citizenanalog/klofi/README.md

# ᚴᛚᚢᚠᛁ keyboard

The ᚴᛚᚢᚠᛁ (Corne v4 variant) keyboard is a split keyboard with 3x5 or 3x6 column staggered keys
and 3 thumb keys.



## EMI FIX (by colinski8189)
- TL;DR: Now a 4 layer board with more components, to mitigate EMI issues (USB and TRS had major issues specifically called out, these have been addressed).

## USBC interconnect
- Eliminates the TRS/TRRS connection in favor of USBC.
- b2b_usbc

## Update
- MX version is currently being tested, 3x5_3_ex2 and 3x6_3_ex2. Physically the same dimensions as corne v4 except for new USBC conn.
- choc versions (3x5 and 3x6 layouts) are routed but not yet produced. Note there are separate PCB files for 3x5 and 3x6.
