citizenanalog/klofi/plates/3x5/pcb/plate-top-cherrymx-ex-3x5.step

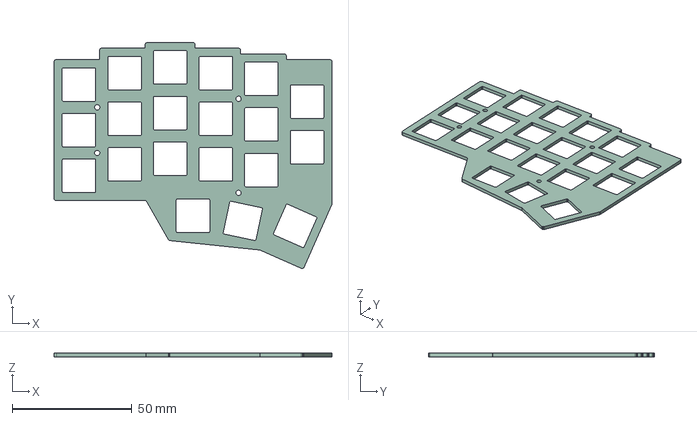
[picture p1: CAD file, 2026-01-19]
plates/3x5/pcb/plate-top-cherrymx-ex-3x5.step
116.1 x 94.4 x 1.51 mm
