citizenanalog/klofi/pcbs/common/left.kicad_sch

## KiCad design pcbs/common/left.kicad_sch (2025-12-11)

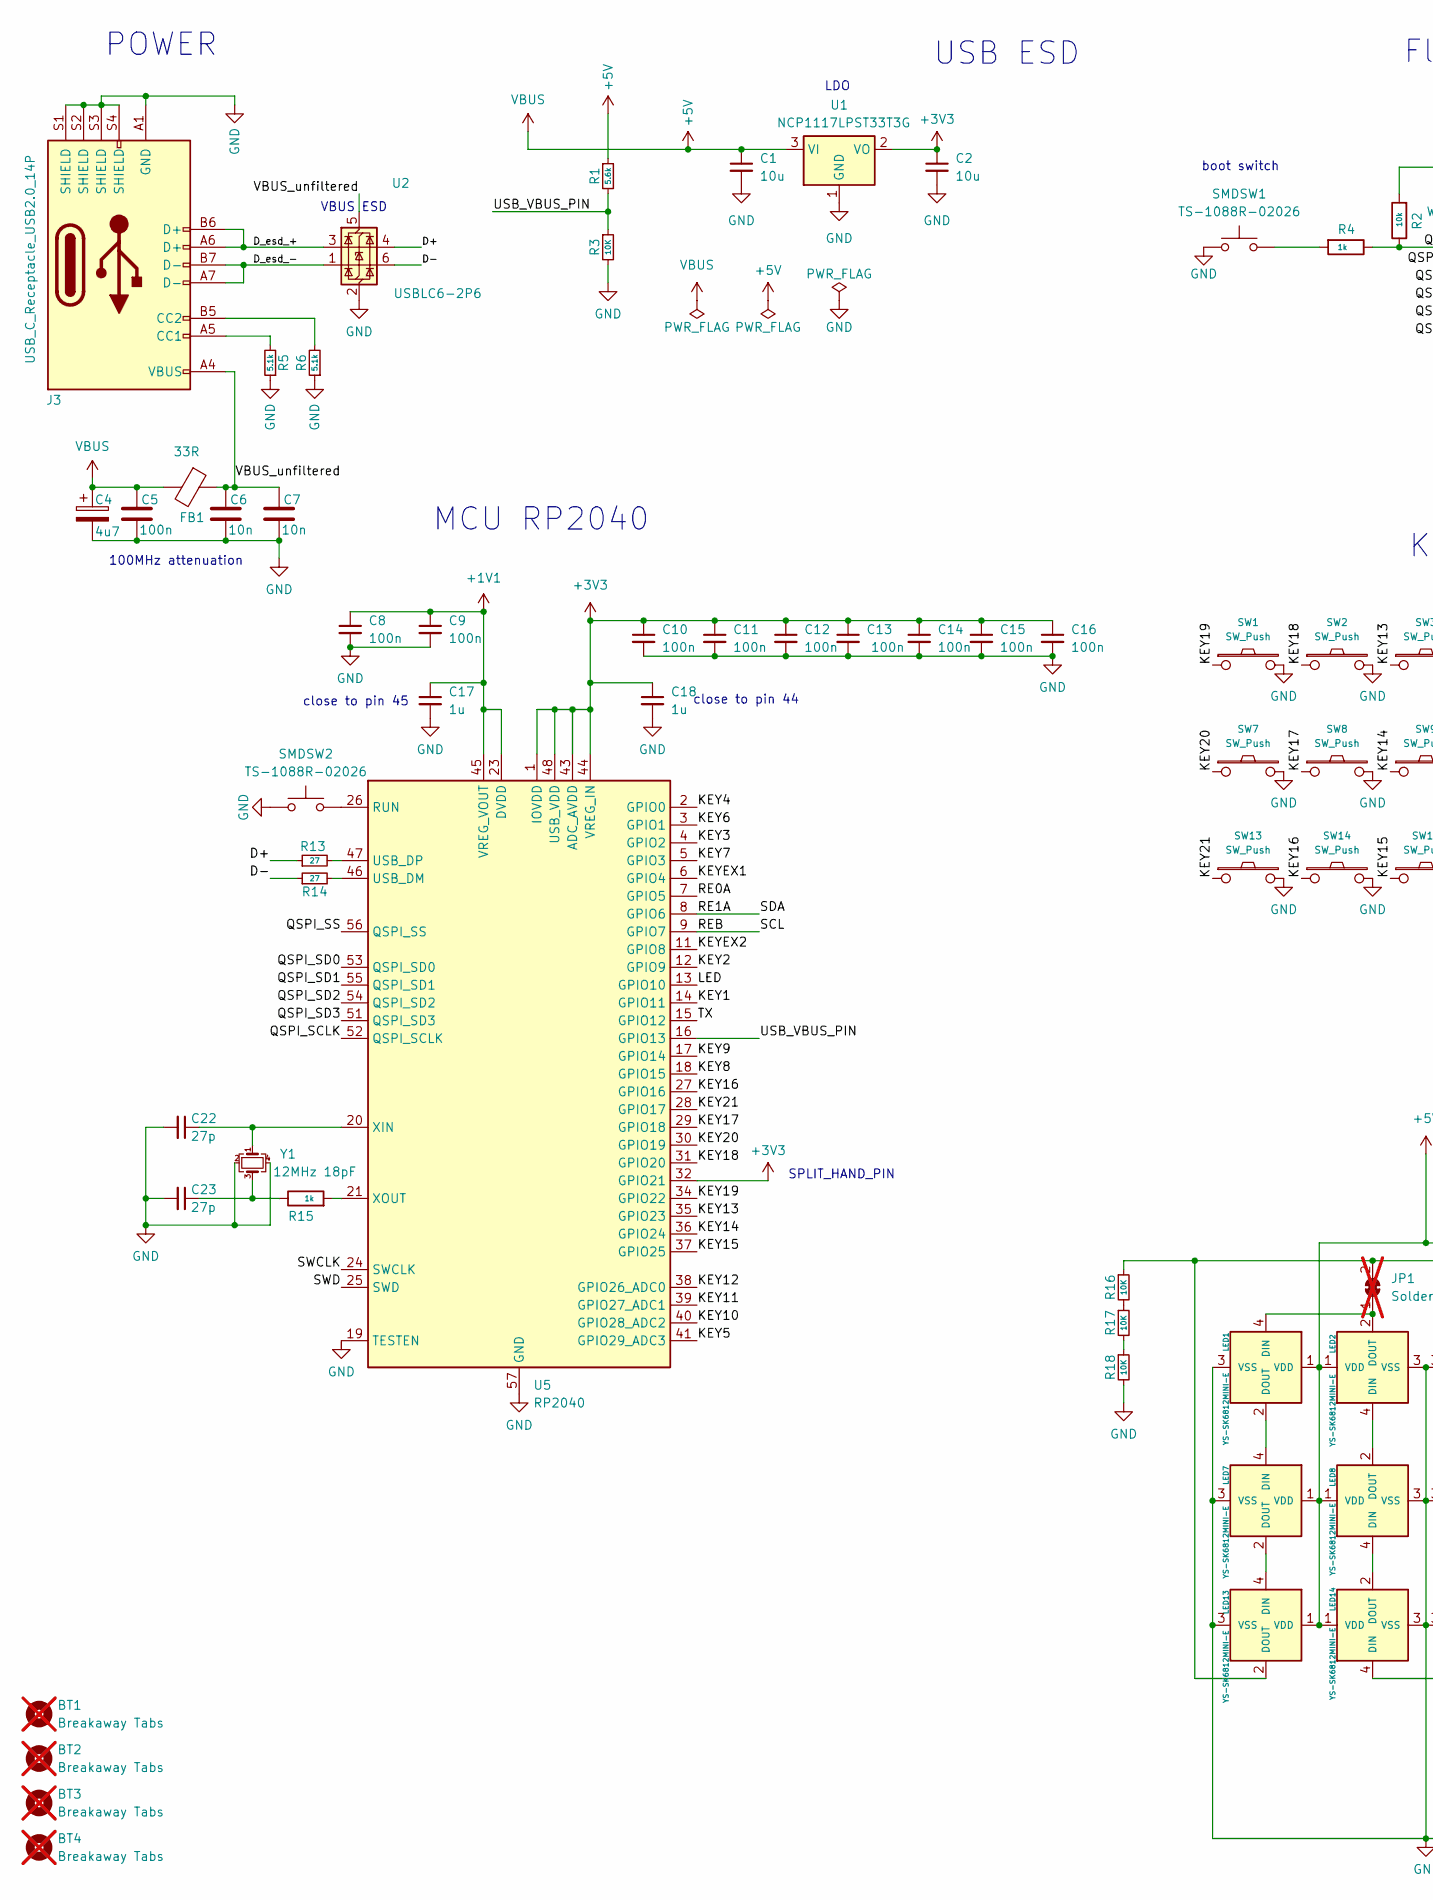
[picture p2: schematic left.kicad_sch, part in row 1, column 1]

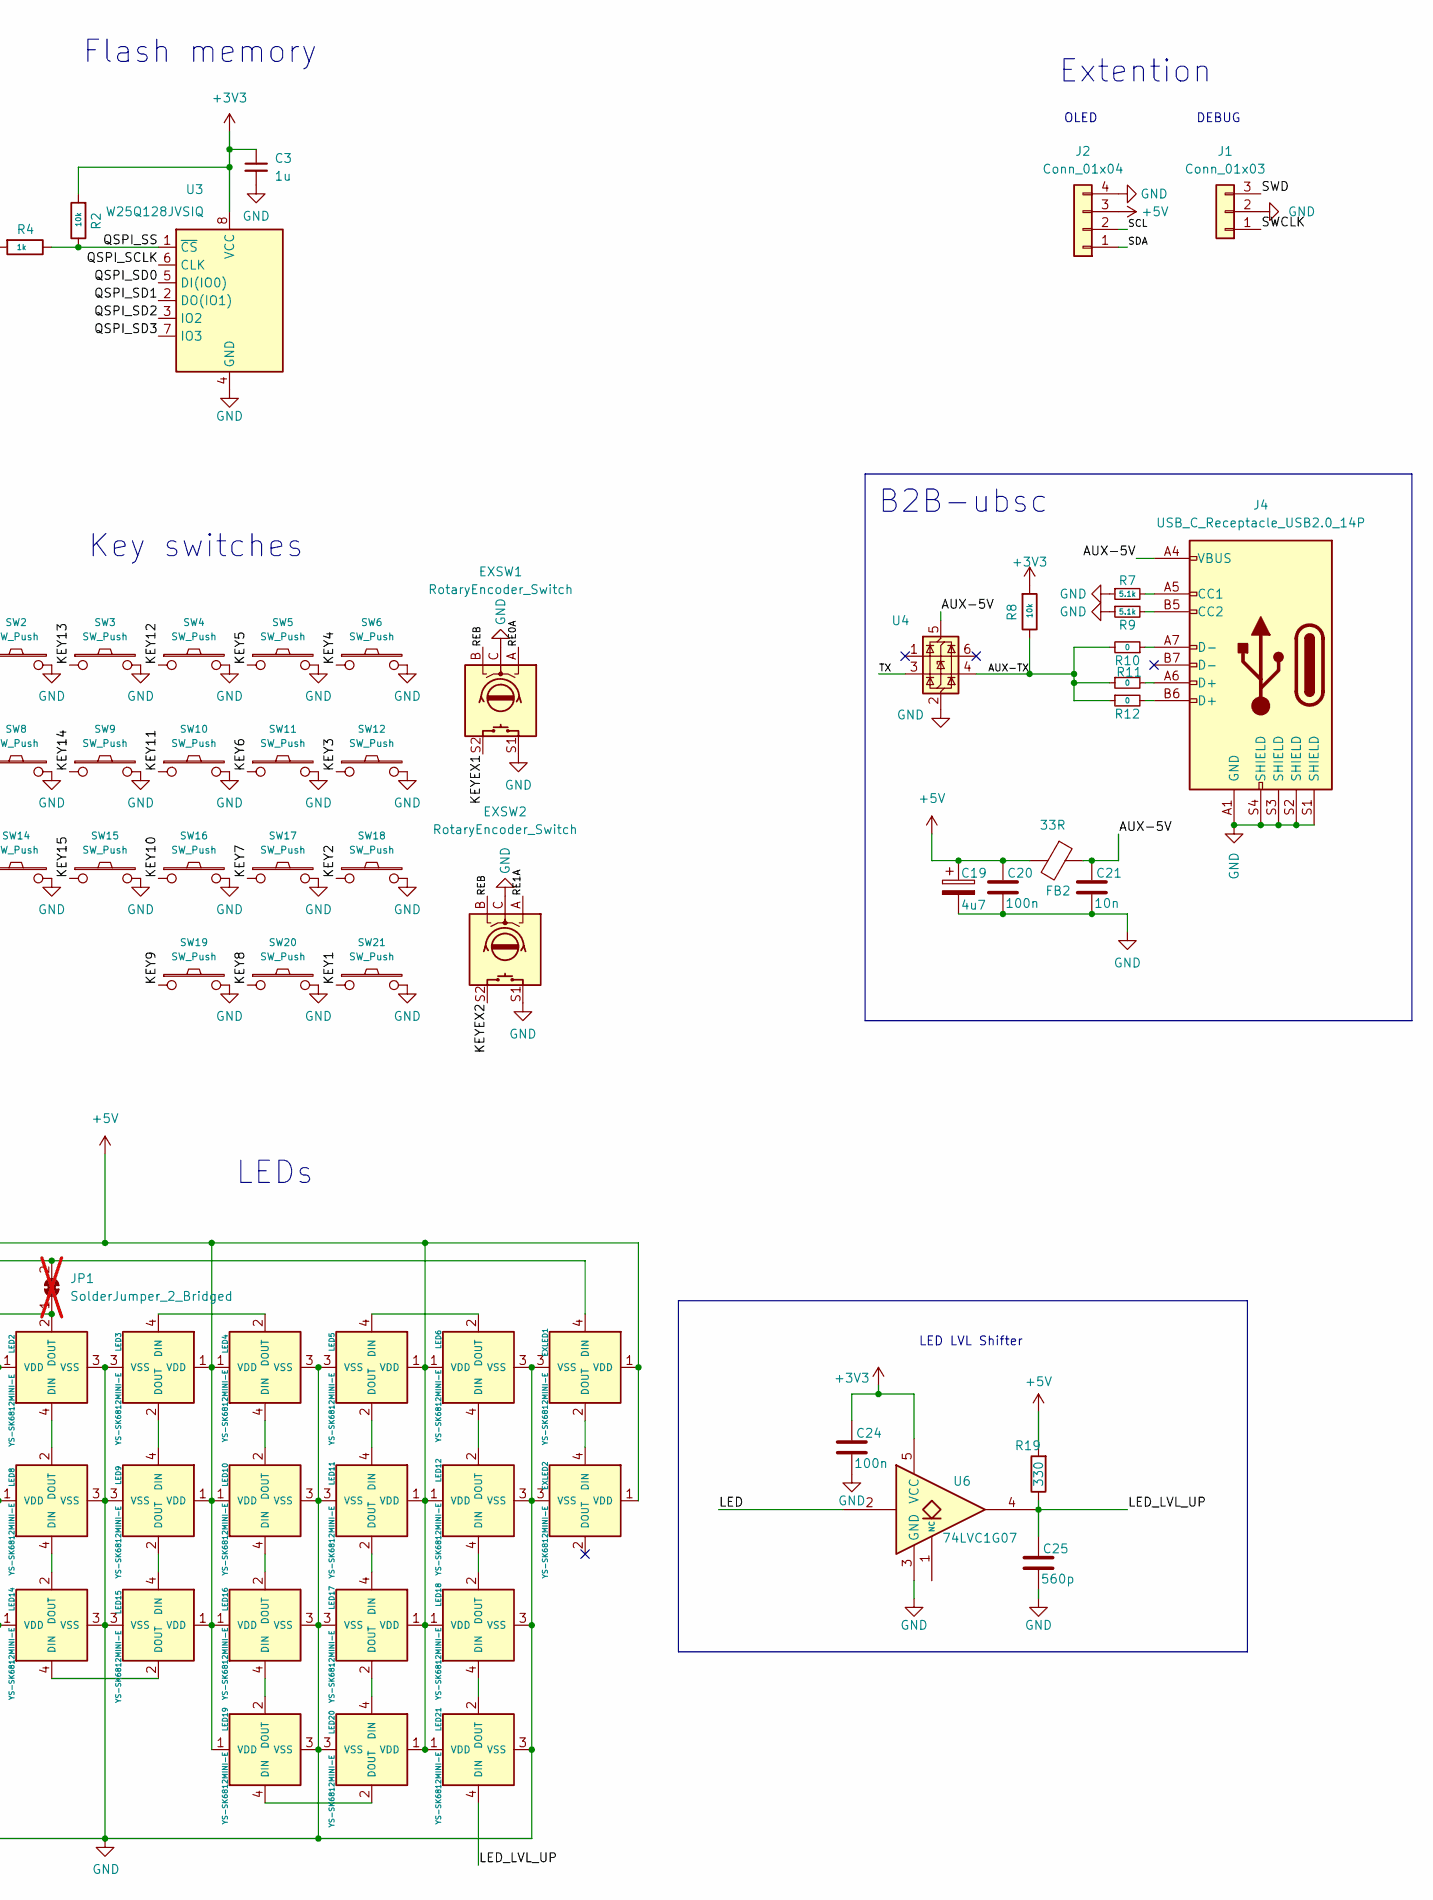
[picture p3: schematic left.kicad_sch, part in row 1, column 2]

Parts:
BT1, BT2, BT3, BT4: Breakaway Tabs; Breakaway_Tabs; not fitted
C1, C2: 10u; C_0402_1005Metric; JLCPCB Part # C15525
C3, C17, C18: 1u; C_0402_1005Metric; JLCPCB Part # C14445
C4, C19: 4u7; C_1210_3225Metric; Manufacturer Part # TCJB475M035R0200; LCSC Part # C2158392
C5, C20, C24: 100n; C_0402_1005Metric; Manufacturer Part # CL05B104KP5NNNC; LCSC Part # C133086
C6, C7, C21: 10n; C_0402_1005Metric; Manufacturer Part # GRM155R71E103KA01D; LCSC Part # C77013
C8, C9, C10, C11, C12, C13, C14, C15, C16: 100n; C_0402_1005Metric; JLCPCB Part # C133086
C22, C23: 27p; C_0402_1005Metric; JLCPCB Part # C86287
C25: 560p; C_0402_1005Metric; Manufacturer Part # GRM1555C1H561JA01D; LCSC Part # C76975
EXLED1, EXLED2: YS-SK6812MINI-E; JLCPCB Part # C5149201
EXSW1, EXSW2: RotaryEncoder_Switch; keyswitch_cherrymx_hotswap_1u_rotary_encoder_ec12; JLCPCB Part # DNP
FB1, FB2: 33R; L_1206_3216Metric; Manufacturer Part # BLM31PG330SN1L; LCSC Part # C6750934
J1: Conn_01x03; PinHeader_1x03_P2.54mm_Vertical; JLCPCB Part # DNP
J2: Conn_01x04; OLED; JLCPCB Part # DNP
J3, J4: USB_C_Receptacle_USB2.0_14P; 2073-USB4105-GF-ACT-ND; Manufacturer Part # USB4105-GF-A; LCSC Part # C3020560
JP1: SolderJumper_2_Bridged; SolderJumper-2_P1.3mm_Open_RoundedPad1.0x1.5mm; JLCPCB Part # DNP; not fitted
LED1, LED2, LED3, LED4, LED5, LED6, LED7, LED8, LED9, LED10, LED11, LED12, LED13, LED14, LED15, LED16, LED17, LED18, LED19, LED20, LED21: YS-SK6812MINI-E; JLCPCB Part # C5149201
R1: 5.6k; R_0402_1005Metric; JLCPCB Part # C25908
R2, R8: 10k; R_0402_1005Metric; JLCPCB Part # C60489
R3, R16, R17, R18: 10K; R_0402_1005Metric; JLCPCB Part # C60489
R4, R15: 1k; R_0402_1005Metric; JLCPCB Part # C71623
R5, R6, R7, R9: 5.1k; R_0402_1005Metric; JLCPCB Part # C105872
R10, R11, R12: 0; R_0402_1005Metric; JLCPCB Part # C25537
R13, R14: 27; R_0402_1005Metric; JLCPCB Part # C138021
R19: 330; R_0402_1005Metric; Manufacturer Part # RC0402FR-07330RL; LCSC Part # C105875
SMDSW1, SMDSW2: TS-1088R-02026; JLCPCB Part # C455280
SW1, SW2, SW3, SW4, SW5, SW6, SW7, SW8, SW9, SW10, SW11, SW12, SW13, SW14, SW15, SW16, SW17, SW18, SW19, SW20, SW21: SW_Push; keyswitch_cherrymx_hotswap_1u; JLCPCB Part # DNP
U1: NCP1117LPST33T3G; SOT-223-3_TabPin2; JLCPCB Part # C146799
U2, U4: USBLC6-2P6; SOT-666; Manufacturer Part # USBLC6-2P6; LCSC Part # C15999
U3: W25Q128JVSIQ; SOIC-8_5.23x5.23mm_P1.27mm; JLCPCB Part # C113767
U5: RP2040; QFN-56-1EP_7x7mm_P0.4mm_EP3.2x3.2mm; JLCPCB Part # C2040
U6: 74LVC1G07; SOT-353_SC-70-5; Manufacturer Part # SN74LVC1G07DCKR; LCSC Part # C7830
Y1: 12MHz 18pF; Crystal_SMD_3225-4Pin_3.2x2.5mm; MFR.Part # Q22FA23V0041800; JLCPCB Part # C91749

Connections:
+1V1: C8.1, C9.1, C17.1, U5.23 (DVDD), U5.45 (VREG_VOUT), U5.50 (DVDD)
+3V3: C2.1, C3.1, C10.1, C11.1, C12.1, C13.1, C14.1, C15.1, C16.1, C18.1, C24.1, R2.2, R8.2, U1.2 (VO), U3.8 (VCC), U5.1 (IOVDD), U5.10 (IOVDD), U5.22 (IOVDD), U5.32 (GPIO21), U5.33 (IOVDD), U5.42 (IOVDD), U5.43 (ADC_AVDD), U5.44 (VREG_IN), U5.48 (USB_VDD), U5.49 (IOVDD), U6.5 (VCC)
+5V: C1.1, C4.1, C5.1, C19.1, C20.1, EXLED1.1 (VDD), EXLED2.1 (VDD), FB1.2, FB2.2, J2.3, LED1.1 (VDD), LED2.1 (VDD), LED3.1 (VDD), LED4.1 (VDD), LED5.1 (VDD), LED6.1 (VDD), LED7.1 (VDD), LED8.1 (VDD), LED9.1 (VDD), LED10.1 (VDD), LED11.1 (VDD), LED12.1 (VDD), LED13.1 (VDD), LED14.1 (VDD), LED15.1 (VDD), LED16.1 (VDD), LED17.1 (VDD), LED18.1 (VDD), LED19.1 (VDD), LED20.1 (VDD), LED21.1 (VDD), R1.1, R19.2, U1.3 (VI)
AUX-5V: C21.1, FB2.1, J4.A4 (VBUS), J4.B4 (VBUS), U4.5 (VBUS)
AUX-TX: R8.1, R10.2, R11.1, R12.1, U4.4 (I/O2)
D+: R13.1, U2.4 (I/O1)
D-: R14.1, U2.6 (I/O2)
D_esd_+: J3.A6 (D+), J3.B6 (D+), U2.3 (I/O1)
D_esd_-: J3.A7 (D-), J3.B7 (D-), U2.1 (I/O2)
GND: C1.2, C2.2, C3.2, C4.2, C5.2, C6.2, C7.2, C8.2, C9.2, C10.2, C11.2, C12.2, C13.2, C14.2, C15.2, C16.2, C17.2, C18.2, C19.2, C20.2, C21.2, C22.2, C23.2, C24.2, C25.2, EXLED1.3 (VSS), EXLED2.3 (VSS), EXSW1.C, EXSW1.S1, EXSW2.C, EXSW2.S1, J1.2, J2.4, J3.A1 (GND), J3.B1 (GND), J3.S1 (SHIELD), J3.S2 (SHIELD), J3.S3 (SHIELD), J3.S4 (SHIELD), J4.A1 (GND), J4.B1 (GND), J4.S1 (SHIELD), J4.S2 (SHIELD), J4.S3 (SHIELD), J4.S4 (SHIELD), LED1.3 (VSS), LED2.3 (VSS), LED3.3 (VSS), LED4.3 (VSS), LED5.3 (VSS), LED6.3 (VSS), LED7.3 (VSS), LED8.3 (VSS), LED9.3 (VSS), LED10.3 (VSS), LED11.3 (VSS), LED12.3 (VSS), LED13.3 (VSS), LED14.3 (VSS), LED15.3 (VSS), LED16.3 (VSS), LED17.3 (VSS), LED18.3 (VSS), LED19.3 (VSS), LED20.3 (VSS), LED21.3 (VSS), R3.2, R5.1, R6.1, R7.1, R9.1, R18.2, SMDSW1.1, SMDSW2.1, SW1.2, SW2.2, SW3.2, SW4.2, SW5.2, SW6.2, SW7.2, SW8.2, SW9.2, SW10.2, SW11.2, SW12.2, SW13.2, SW14.2, SW15.2, SW16.2, SW17.2, SW18.2, SW19.2, SW20.2, SW21.2, U1.1 (GND), U2.2 (GND), U3.4 (GND), U4.2 (GND), U5.19 (TESTEN), U5.57 (GND), U6.3 (GND), Y1.2, Y1.4
KEY1: SW21.1, U5.14 (GPIO11)
KEY2: SW18.1, U5.12 (GPIO9)
KEY3: SW12.1, U5.4 (GPIO2)
KEY4: SW6.1, U5.2 (GPIO0)
KEY5: SW5.1, U5.41 (GPIO29_ADC3)
KEY6: SW11.1, U5.3 (GPIO1)
KEY7: SW17.1, U5.5 (GPIO3)
KEY8: SW20.1, U5.18 (GPIO15)
KEY9: SW19.1, U5.17 (GPIO14)
KEY10: SW16.1, U5.40 (GPIO28_ADC2)
KEY11: SW10.1, U5.39 (GPIO27_ADC1)
KEY12: SW4.1, U5.38 (GPIO26_ADC0)
KEY13: SW3.1, U5.35 (GPIO23)
KEY14: SW9.1, U5.36 (GPIO24)
KEY15: SW15.1, U5.37 (GPIO25)
KEY16: SW14.1, U5.27 (GPIO16)
KEY17: SW8.1, U5.29 (GPIO18)
KEY18: SW2.1, U5.31 (GPIO20)
KEY19: SW1.1, U5.34 (GPIO22)
KEY20: SW7.1, U5.30 (GPIO19)
KEY21: SW13.1, U5.28 (GPIO17)
KEYEX1: EXSW1.S2, U5.6 (GPIO4)
KEYEX2: EXSW2.S2, U5.11 (GPIO8)
LED: U5.13 (GPIO10), U6.2
LED_LVL_UP: C25.1, LED21.4 (DIN), R19.1, U6.4
unnamed: C22.1, U5.20 (XIN), Y1.1
unnamed: C23.1, R15.1, Y1.3
unnamed: EXLED1.2 (DOUT), EXLED2.4 (DIN)
unnamed: EXLED1.4 (DIN), JP1.2 (B), LED13.2 (DOUT), R16.1
unnamed: J3.A5 (CC1), R5.2
unnamed: J3.B5 (CC2), R6.2
unnamed: J4.A5 (CC1), R7.2
unnamed: J4.A6 (D+), R11.2
unnamed: J4.A7 (D-), R10.1
unnamed: J4.B5 (CC2), R9.2
unnamed: J4.B6 (D+), R12.2
unnamed: JP1.1 (A), LED1.4 (DIN), LED2.2 (DOUT)
unnamed: LED1.2 (DOUT), LED7.4 (DIN)
unnamed: LED2.4 (DIN), LED8.2 (DOUT)
unnamed: LED3.2 (DOUT), LED9.4 (DIN)
unnamed: LED3.4 (DIN), LED4.2 (DOUT)
unnamed: LED5.4 (DIN), LED6.2 (DOUT)
unnamed: LED4.4 (DIN), LED10.2 (DOUT)
unnamed: LED10.4 (DIN), LED16.2 (DOUT)
unnamed: LED11.2 (DOUT), LED17.4 (DIN)
unnamed: LED5.2 (DOUT), LED11.4 (DIN)
unnamed: LED6.4 (DIN), LED12.2 (DOUT)
unnamed: LED12.4 (DIN), LED18.2 (DOUT)
unnamed: LED7.2 (DOUT), LED13.4 (DIN)
unnamed: LED8.4 (DIN), LED14.2 (DOUT)
unnamed: LED14.4 (DIN), LED15.2 (DOUT)
unnamed: LED9.2 (DOUT), LED15.4 (DIN)
unnamed: LED16.4 (DIN), LED19.2 (DOUT)
unnamed: LED17.2 (DOUT), LED20.4 (DIN)
unnamed: LED18.4 (DIN), LED21.2 (DOUT)
unnamed: LED19.4 (DIN), LED20.2 (DOUT)
unnamed: R4.2, SMDSW1.2
unnamed: R13.2, U5.47 (USB_DP)
unnamed: R14.2, U5.46 (USB_DM)
unnamed: R15.2, U5.21 (XOUT)
unnamed: R16.2, R17.1
unnamed: R17.2, R18.1
unnamed: SMDSW2.2, U5.26 (RUN)
QSPI_SCLK: U3.6 (CLK), U5.52 (QSPI_SCLK)
QSPI_SD0: U3.5 (DI(IO0)), U5.53 (QSPI_SD0)
QSPI_SD1: U3.2 (DO(IO1)), U5.55 (QSPI_SD1)
QSPI_SD2: U3.3 (IO2), U5.54 (QSPI_SD2)
QSPI_SD3: U3.7 (IO3), U5.51 (QSPI_SD3)
QSPI_SS: R2.1, R4.1, U3.1 (~CS), U5.56 (QSPI_SS)
RE0A: EXSW1.A, U5.7 (GPIO5)
RE1A: EXSW2.A, J2.1, U5.8 (GPIO6)
REB: EXSW1.B, EXSW2.B, J2.2, U5.9 (GPIO7)
SWCLK: J1.1, U5.24 (SWCLK)
SWD: J1.3, U5.25 (SWD)
TX: U4.3 (I/O2), U5.15 (GPIO12)
USB_VBUS_PIN: R1.2, R3.1, U5.16 (GPIO13)
VBUS_unfiltered: C6.1, C7.1, FB1.1, J3.A4 (VBUS), J3.B4 (VBUS), U2.5 (VBUS)

Notes on the sheet:
MCU RP2040
Key switches
OLED
100MHz attenuation
close to pin 45
DEBUG
LED LVL Shifter
USB ESD
LDO
Flash memory
POWER
LEDs
Extention
VBUS ESD
SPLIT_HAND_PIN
boot switch
B2B-ubsc
close to pin 44
