citizenanalog/klofi/pcbs/common/right.kicad_sch

## KiCad design pcbs/common/right.kicad_sch (2025-12-11)

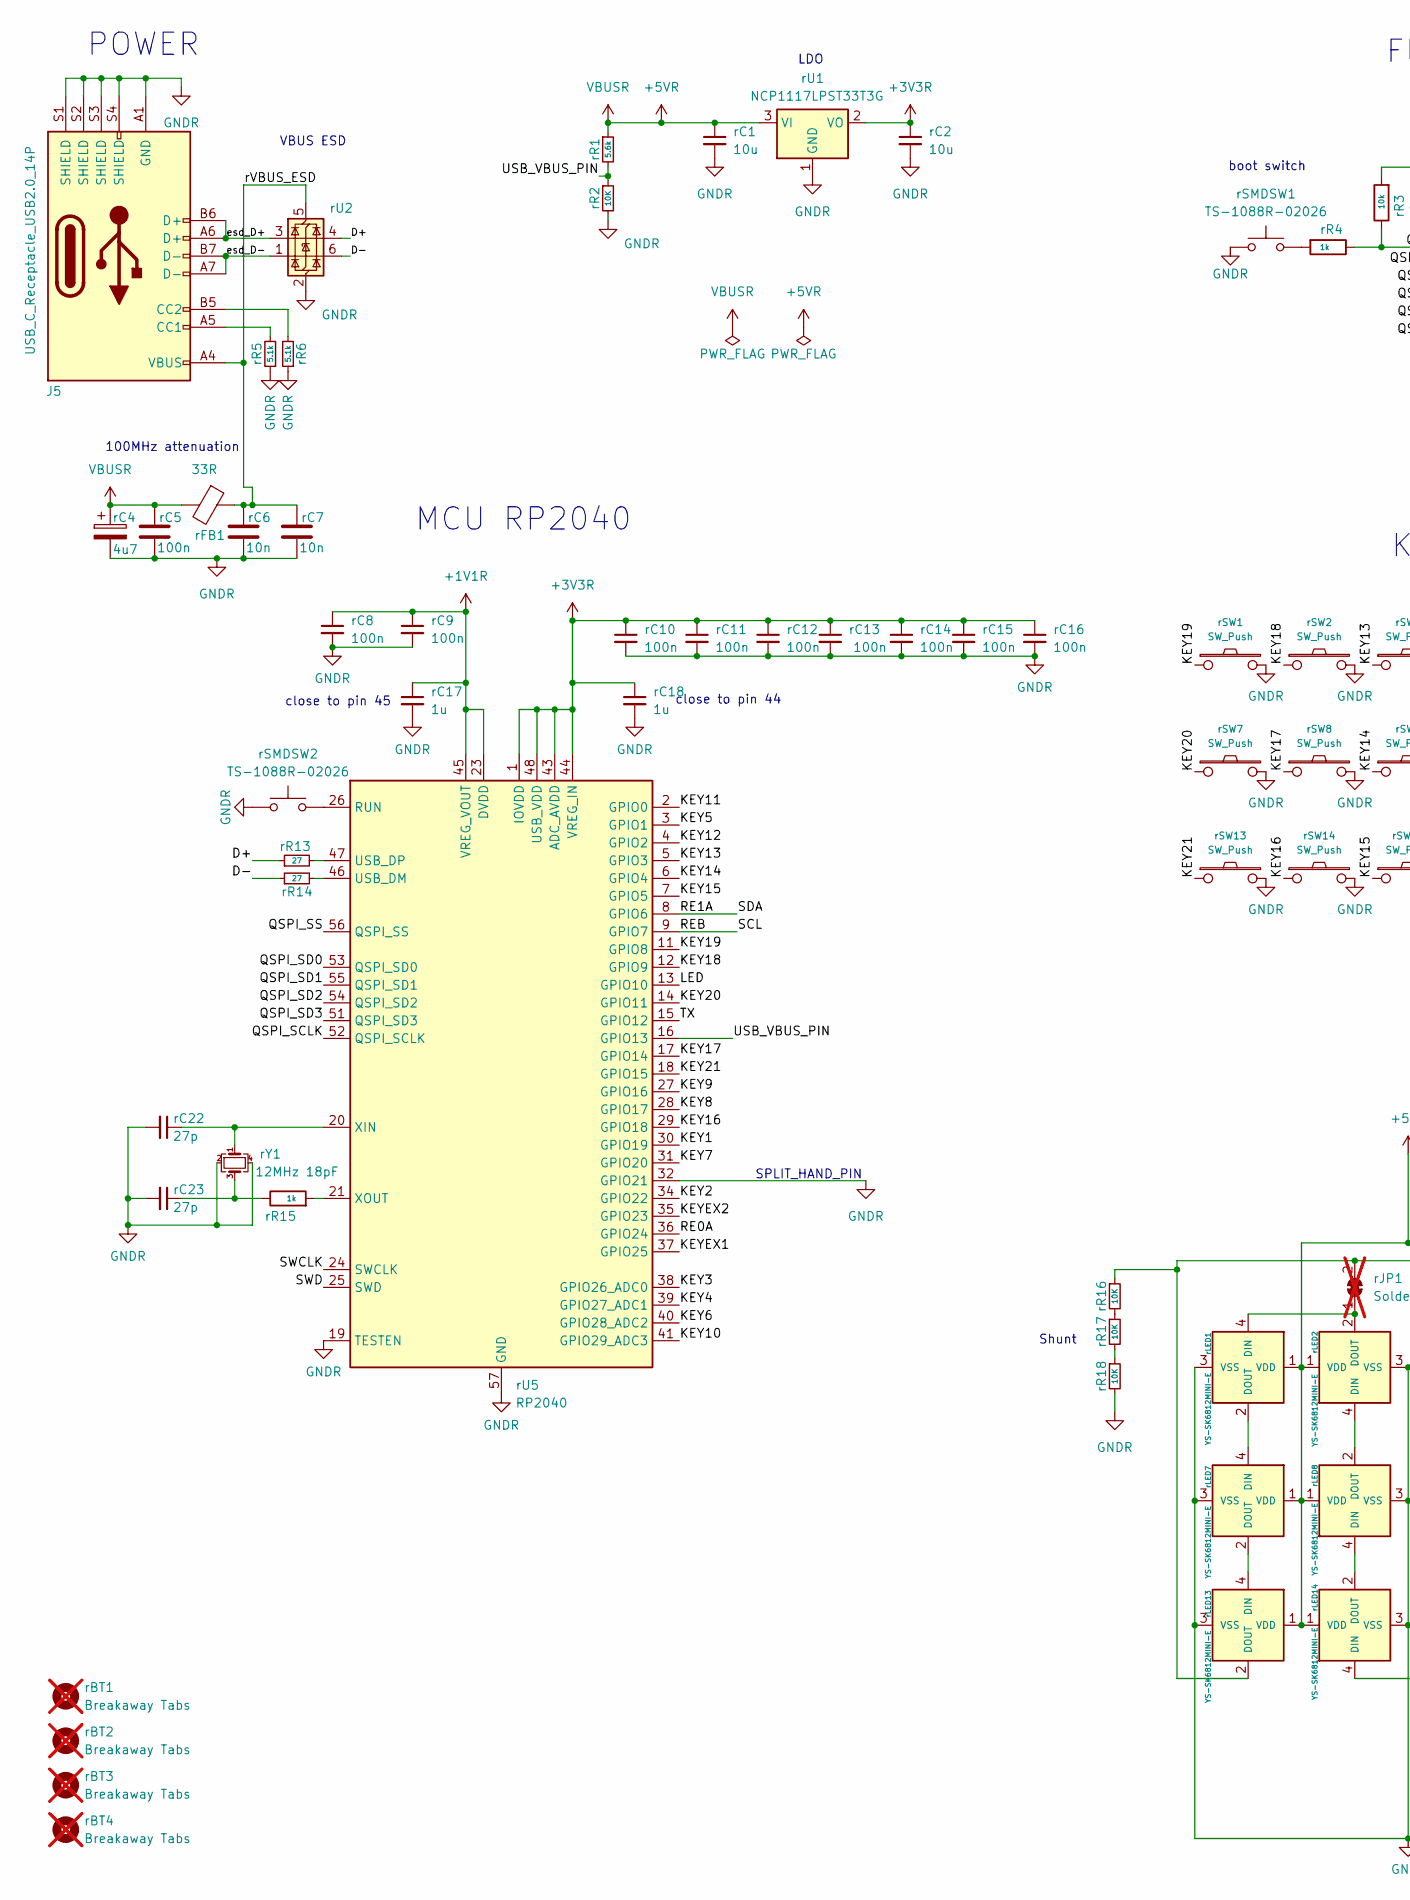
[picture p4: schematic right.kicad_sch, part in row 1, column 1]

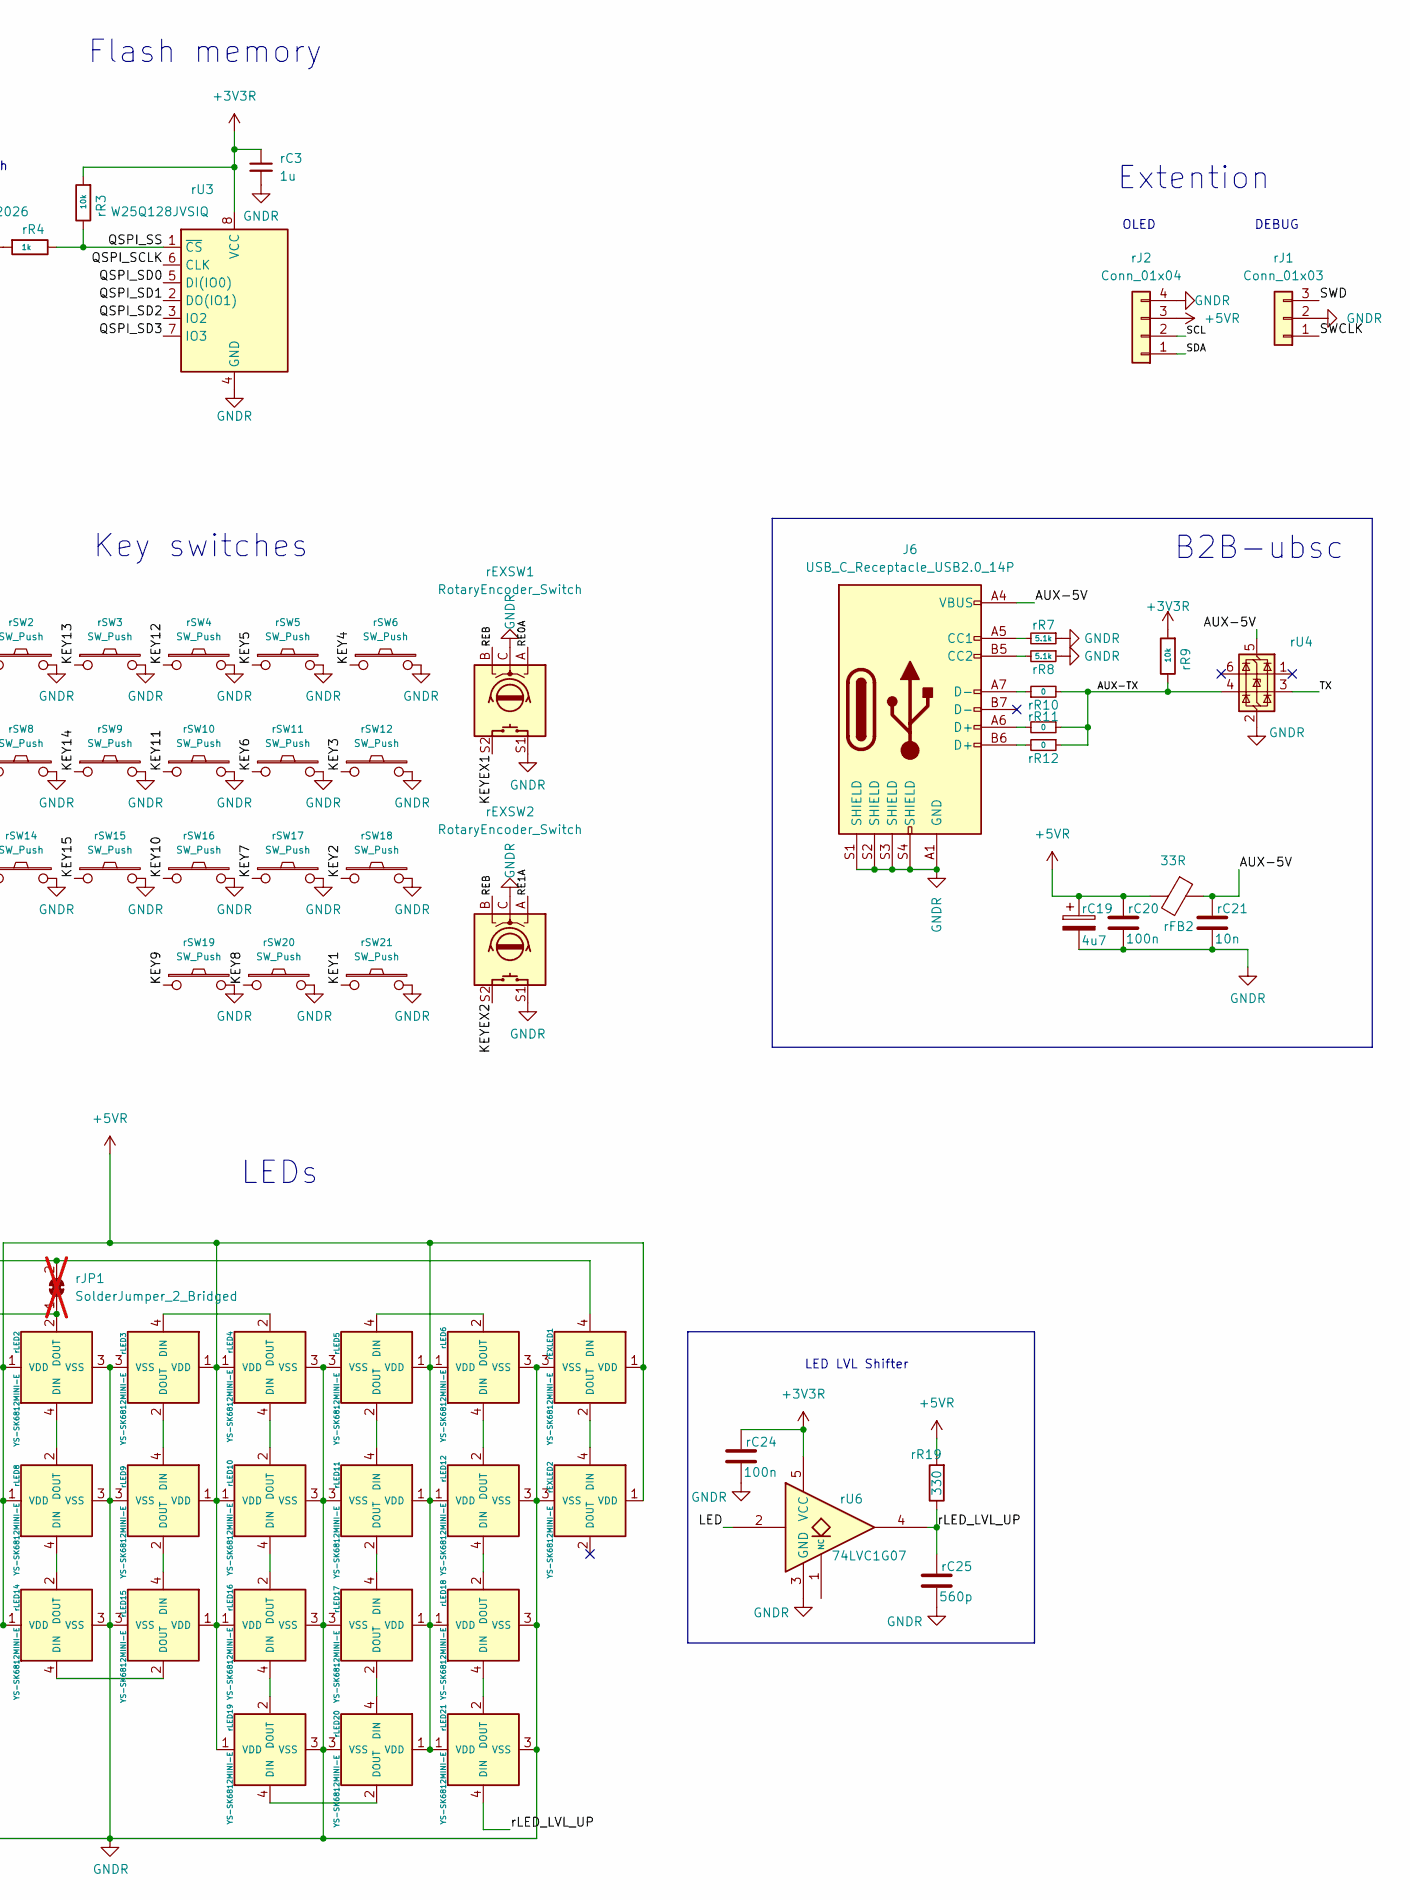
[picture p5: schematic right.kicad_sch, part in row 1, column 2]

Parts:
J5, J6: USB_C_Receptacle_USB2.0_14P; 2073-USB4105-GF-ACT-ND; Manufacturer Part # USB4105-GF-A; LCSC Part # C3020560
rBT1, rBT2, rBT3, rBT4: Breakaway Tabs; Breakaway_Tabs; JLCPCB Part # DNP; not fitted
rC1, rC2: 10u; C_0402_1005Metric; JLCPCB Part # C15525
rC3, rC17, rC18: 1u; C_0402_1005Metric; JLCPCB Part # C14445
rC4, rC19: 4u7; C_1210_3225Metric; Manufacturer Part # TCJB475M035R0200; LCSC Part # C2158392
rC5, rC20, rC24: 100n; C_0402_1005Metric; Manufacturer Part # CL05B104KP5NNNC; LCSC Part # C133086
rC6, rC7, rC21: 10n; C_0402_1005Metric; Manufacturer Part # GRM155R71E103KA01D; LCSC Part # C77013
rC8, rC9, rC10, rC11, rC12, rC13, rC14, rC15, rC16: 100n; C_0402_1005Metric; JLCPCB Part # C133086
rC22, rC23: 27p; C_0402_1005Metric; JLCPCB Part # C107002
rC25: 560p; C_0402_1005Metric; Manufacturer Part # GRM1555C1H561JA01D; LCSC Part # C76975
rEXLED1, rEXLED2: YS-SK6812MINI-E; JLCPCB Part # C5149201
rEXSW1, rEXSW2: RotaryEncoder_Switch; keyswitch_cherrymx_hotswap_1u_rotary_encoder_ec12; JLCPCB Part # DNP
rFB1, rFB2: 33R; L_1206_3216Metric; Manufacturer Part # BLM31PG330SN1L; LCSC Part # C6750934
rJ1: Conn_01x03; PinHeader_1x03_P2.54mm_Vertical; JLCPCB Part # DNP
rJ2: Conn_01x04; OLED; JLCPCB Part # DNP
rJP1: SolderJumper_2_Bridged; SolderJumper-2_P1.3mm_Open_RoundedPad1.0x1.5mm; JLCPCB Part # DNP; not fitted
rLED1, rLED2, rLED3, rLED4, rLED5, rLED6, rLED7, rLED8, rLED9, rLED10, rLED11, rLED12, rLED13, rLED14, rLED15, rLED16, rLED17, rLED18, rLED19, rLED20, rLED21: YS-SK6812MINI-E; JLCPCB Part # C5149201
rR1: 5.6k; R_0402_1005Metric; JLCPCB Part # C25908
rR2, rR16, rR17, rR18: 10K; R_0402_1005Metric; JLCPCB Part # C60489
rR3, rR9: 10k; R_0402_1005Metric; JLCPCB Part # C60489
rR4, rR15: 1k; R_0402_1005Metric; JLCPCB Part # C71623
rR5, rR6, rR7, rR8: 5.1k; R_0402_1005Metric; JLCPCB Part # C105872
rR10, rR11, rR12: 0; R_0402_1005Metric; JLCPCB Part # C60485
rR13, rR14: 27; R_0402_1005Metric; JLCPCB Part # C138021
rR19: 330; R_0402_1005Metric; Manufacturer Part # RC0402FR-07330RL; LCSC Part # C105875
rSMDSW1, rSMDSW2: TS-1088R-02026; JLCPCB Part # C455280
rSW1, rSW2, rSW3, rSW4, rSW5, rSW6, rSW7, rSW8, rSW9, rSW10, rSW11, rSW12, rSW13, rSW14, rSW15, rSW16, rSW17, rSW18, rSW19, rSW20, rSW21: SW_Push; keyswitch_cherrymx_hotswap_1u; JLCPCB Part # DNP
rU1: NCP1117LPST33T3G; SOT-223-3_TabPin2; JLCPCB Part # C146799
rU2, rU4: USBLC6-2P6; SOT-666; Manufacturer Part # USBLC6-2P6; LCSC Part # C15999
rU3: W25Q128JVSIQ; SOIC-8_5.23x5.23mm_P1.27mm; JLCPCB Part # C113767
rU5: RP2040; QFN-56-1EP_7x7mm_P0.4mm_EP3.2x3.2mm; JLCPCB Part # C2040
rU6: 74LVC1G07; SOT-353_SC-70-5; Manufacturer Part # SN74LVC1G07DCKR; LCSC Part # C7830
rY1: 12MHz 18pF; Crystal_SMD_3225-4Pin_3.2x2.5mm; MFR.Part # Q22FA23V0041800; JLCPCB Part # C91749

Connections:
+1V1R: rC8.1, rC9.1, rC17.1, rU5.23 (DVDD), rU5.45 (VREG_VOUT), rU5.50 (DVDD)
+3V3R: rC2.1, rC3.1, rC10.1, rC11.1, rC12.1, rC13.1, rC14.1, rC15.1, rC16.1, rC18.1, rC24.1, rR3.2, rR9.2, rU1.2 (VO), rU3.8 (VCC), rU5.1 (IOVDD), rU5.10 (IOVDD), rU5.22 (IOVDD), rU5.33 (IOVDD), rU5.42 (IOVDD), rU5.43 (ADC_AVDD), rU5.44 (VREG_IN), rU5.48 (USB_VDD), rU5.49 (IOVDD), rU6.5 (VCC)
+5VR: rC1.1, rC4.1, rC5.1, rC19.1, rC20.1, rEXLED1.1 (VDD), rEXLED2.1 (VDD), rFB1.2, rFB2.2, rJ2.3, rLED1.1 (VDD), rLED2.1 (VDD), rLED3.1 (VDD), rLED4.1 (VDD), rLED5.1 (VDD), rLED6.1 (VDD), rLED7.1 (VDD), rLED8.1 (VDD), rLED9.1 (VDD), rLED10.1 (VDD), rLED11.1 (VDD), rLED12.1 (VDD), rLED13.1 (VDD), rLED14.1 (VDD), rLED15.1 (VDD), rLED16.1 (VDD), rLED17.1 (VDD), rLED18.1 (VDD), rLED19.1 (VDD), rLED20.1 (VDD), rLED21.1 (VDD), rR1.1, rR19.2, rU1.3 (VI)
AUX-5V: J6.A4 (VBUS), J6.B4 (VBUS), rC21.1, rFB2.1, rU4.5 (VBUS)
AUX-TX: rR9.1, rR10.2, rR11.1, rR12.1, rU4.4 (I/O2)
D+: rR13.1, rU2.4 (I/O1)
D-: rR14.1, rU2.6 (I/O2)
GNDR: J5.A1 (GND), J5.B1 (GND), J5.S1 (SHIELD), J5.S2 (SHIELD), J5.S3 (SHIELD), J5.S4 (SHIELD), J6.A1 (GND), J6.B1 (GND), J6.S1 (SHIELD), J6.S2 (SHIELD), J6.S3 (SHIELD), J6.S4 (SHIELD), rC1.2, rC2.2, rC3.2, rC4.2, rC5.2, rC6.2, rC7.2, rC8.2, rC9.2, rC10.2, rC11.2, rC12.2, rC13.2, rC14.2, rC15.2, rC16.2, rC17.2, rC18.2, rC19.2, rC20.2, rC21.2, rC22.2, rC23.2, rC24.2, rC25.2, rEXLED1.3 (VSS), rEXLED2.3 (VSS), rEXSW1.C, rEXSW1.S1, rEXSW2.C, rEXSW2.S1, rJ1.2, rJ2.4, rLED1.3 (VSS), rLED2.3 (VSS), rLED3.3 (VSS), rLED4.3 (VSS), rLED5.3 (VSS), rLED6.3 (VSS), rLED7.3 (VSS), rLED8.3 (VSS), rLED9.3 (VSS), rLED10.3 (VSS), rLED11.3 (VSS), rLED12.3 (VSS), rLED13.3 (VSS), rLED14.3 (VSS), rLED15.3 (VSS), rLED16.3 (VSS), rLED17.3 (VSS), rLED18.3 (VSS), rLED19.3 (VSS), rLED20.3 (VSS), rLED21.3 (VSS), rR2.2, rR5.1, rR6.1, rR7.1, rR8.1, rR18.2, rSMDSW1.1, rSMDSW2.1, rSW1.2, rSW2.2, rSW3.2, rSW4.2, rSW5.2, rSW6.2, rSW7.2, rSW8.2, rSW9.2, rSW10.2, rSW11.2, rSW12.2, rSW13.2, rSW14.2, rSW15.2, rSW16.2, rSW17.2, rSW18.2, rSW19.2, rSW20.2, rSW21.2, rU1.1 (GND), rU2.2 (GND), rU3.4 (GND), rU4.2 (GND), rU5.19 (TESTEN), rU5.32 (GPIO21), rU5.57 (GND), rU6.3 (GND), rY1.2, rY1.4
KEY1: rSW21.1, rU5.30 (GPIO19)
KEY2: rSW18.1, rU5.34 (GPIO22)
KEY3: rSW12.1, rU5.38 (GPIO26_ADC0)
KEY4: rSW6.1, rU5.39 (GPIO27_ADC1)
KEY5: rSW5.1, rU5.3 (GPIO1)
KEY6: rSW11.1, rU5.40 (GPIO28_ADC2)
KEY7: rSW17.1, rU5.31 (GPIO20)
KEY8: rSW20.1, rU5.28 (GPIO17)
KEY9: rSW19.1, rU5.27 (GPIO16)
KEY10: rSW16.1, rU5.41 (GPIO29_ADC3)
KEY11: rSW10.1, rU5.2 (GPIO0)
KEY12: rSW4.1, rU5.4 (GPIO2)
KEY13: rSW3.1, rU5.5 (GPIO3)
KEY14: rSW9.1, rU5.6 (GPIO4)
KEY15: rSW15.1, rU5.7 (GPIO5)
KEY16: rSW14.1, rU5.29 (GPIO18)
KEY17: rSW8.1, rU5.17 (GPIO14)
KEY18: rSW2.1, rU5.12 (GPIO9)
KEY19: rSW1.1, rU5.11 (GPIO8)
KEY20: rSW7.1, rU5.14 (GPIO11)
KEY21: rSW13.1, rU5.18 (GPIO15)
KEYEX1: rEXSW1.S2, rU5.37 (GPIO25)
KEYEX2: rEXSW2.S2, rU5.35 (GPIO23)
LED: rU5.13 (GPIO10), rU6.2
unnamed: J5.A5 (CC1), rR5.2
unnamed: J5.B5 (CC2), rR6.2
unnamed: J6.A5 (CC1), rR7.2
unnamed: J6.A6 (D+), rR11.2
unnamed: J6.A7 (D-), rR10.1
unnamed: J6.B5 (CC2), rR8.2
unnamed: J6.B6 (D+), rR12.2
unnamed: rC22.1, rU5.20 (XIN), rY1.1
unnamed: rC23.1, rR15.1, rY1.3
unnamed: rEXLED1.2 (DOUT), rEXLED2.4 (DIN)
unnamed: rEXLED1.4 (DIN), rJP1.2 (B), rLED13.2 (DOUT), rR16.1
unnamed: rJP1.1 (A), rLED1.4 (DIN), rLED2.2 (DOUT)
unnamed: rLED1.2 (DOUT), rLED7.4 (DIN)
unnamed: rLED2.4 (DIN), rLED8.2 (DOUT)
unnamed: rLED3.2 (DOUT), rLED9.4 (DIN)
unnamed: rLED3.4 (DIN), rLED4.2 (DOUT)
unnamed: rLED5.4 (DIN), rLED6.2 (DOUT)
unnamed: rLED4.4 (DIN), rLED10.2 (DOUT)
unnamed: rLED10.4 (DIN), rLED16.2 (DOUT)
unnamed: rLED11.2 (DOUT), rLED17.4 (DIN)
unnamed: rLED5.2 (DOUT), rLED11.4 (DIN)
unnamed: rLED6.4 (DIN), rLED12.2 (DOUT)
unnamed: rLED12.4 (DIN), rLED18.2 (DOUT)
unnamed: rLED7.2 (DOUT), rLED13.4 (DIN)
unnamed: rLED8.4 (DIN), rLED14.2 (DOUT)
unnamed: rLED14.4 (DIN), rLED15.2 (DOUT)
unnamed: rLED9.2 (DOUT), rLED15.4 (DIN)
unnamed: rLED16.4 (DIN), rLED19.2 (DOUT)
unnamed: rLED17.2 (DOUT), rLED20.4 (DIN)
unnamed: rLED18.4 (DIN), rLED21.2 (DOUT)
unnamed: rLED19.4 (DIN), rLED20.2 (DOUT)
unnamed: rR4.2, rSMDSW1.2
unnamed: rR13.2, rU5.47 (USB_DP)
unnamed: rR14.2, rU5.46 (USB_DM)
unnamed: rR15.2, rU5.21 (XOUT)
unnamed: rR16.2, rR17.1
unnamed: rR17.2, rR18.1
unnamed: rSMDSW2.2, rU5.26 (RUN)
QSPI_SCLK: rU3.6 (CLK), rU5.52 (QSPI_SCLK)
QSPI_SD0: rU3.5 (DI(IO0)), rU5.53 (QSPI_SD0)
QSPI_SD1: rU3.2 (DO(IO1)), rU5.55 (QSPI_SD1)
QSPI_SD2: rU3.3 (IO2), rU5.54 (QSPI_SD2)
QSPI_SD3: rU3.7 (IO3), rU5.51 (QSPI_SD3)
QSPI_SS: rR3.1, rR4.1, rU3.1 (~CS), rU5.56 (QSPI_SS)
RE0A: rEXSW1.A, rU5.36 (GPIO24)
RE1A: rEXSW2.A, rJ2.1, rU5.8 (GPIO6)
REB: rEXSW1.B, rEXSW2.B, rJ2.2, rU5.9 (GPIO7)
SWCLK: rJ1.1, rU5.24 (SWCLK)
SWD: rJ1.3, rU5.25 (SWD)
TX: rU4.3 (I/O2), rU5.15 (GPIO12)
USB_VBUS_PIN: rR1.2, rR2.1, rU5.16 (GPIO13)
esd_D+: J5.A6 (D+), J5.B6 (D+), rU2.3 (I/O1)
esd_D-: J5.A7 (D-), J5.B7 (D-), rU2.1 (I/O2)
rLED_LVL_UP: rC25.1, rLED21.4 (DIN), rR19.1, rU6.4
rVBUS_ESD: J5.A4 (VBUS), J5.B4 (VBUS), rC6.1, rC7.1, rFB1.1, rU2.5 (VBUS)

Notes on the sheet:
B2B-ubsc
Flash memory
MCU RP2040
100MHz attenuation
Shunt
DEBUG
POWER
boot switch
LED LVL Shifter
LDO
Key switches
LEDs
Extention
VBUS ESD
OLED
close to pin 45
close to pin 44
SPLIT_HAND_PIN
