citizenanalog/klofi/(commit log)

2025-10-13 PCB re-route for EMI (cherry)
    [BOM-cski-corne-cherry.csv, corne-cherry.kicad_sch, left.kicad_sch, right.kicad_sch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]
2025-10-13 PCB re-route README edit
2025-11-25 Change keyboard name to ᚴᛚᚢᚠᛁ and revise description
    Updated the keyboard name and clarified description.
2025-12-11 Add file.txt to pcbs directory
2025-12-17 Revise update section with MX and choc version info
    Updated the update section with specific version details and PCB file notes.
